Kempf/balsabridge/README.md

Sad but true.
===========
prediction
