Kempf/balsabridge/Report/report.tex

\documentclass[12pt]{article}
	\usepackage{graphicx,amsmath,textcomp}
	\usepackage[round]{natbib}
	\usepackage[margin=3cm]{geometry}
	\linespread{1.3}
	\bibliographystyle{plainnat}
	\title{
		Group \#07 \\
		Bridge-00 \\
		18g, 1700N \\[1cm]
		
	}
	\author{
		Alex Miles \\ u5568175 \\ 16.7\%
		\and Arlene Mendoza \\ u5589650 \\ 16.7\%
		\and Itsuki Nishida \\ u5578430 \\ 16.7\%
		\and Paul Apelt \\ u5568225 \\ 16.7\%
		\and Stephen Lonergan \\ u5349877 \\ 16.7\%
		\and Thomas Hale \\ u5568225 \\ 16.7\%
	}
\begin{document}
	\maketitle
	\thispagestyle{empty}
	\setcounter{page}{0}
	\section{Design}
		% design assumptions and methods
		\subsection{Assumptions}
		During the design process, the following assumptions have been made \citep[p.~264]{tbook}:
		\begin{enumerate}
			\item All loadings are applied at the joint,
			\item Weight of the members neglected,
			\item Joints are smooth (friction-less) pins,
			\item Each member has no more than two joints.
		\end{enumerate}

		\subsection{Considerations}
The task was set with a design criteria to span a gap of 180~mm and a width of 70~mm. The entire bridge also the bridge should weigh less than 18~g. The goal was to be able to hold the largest weight possible.

A very important design consideration was how many 2D truss panels should be used. The idea was by having more panels the design would be distributing the weight and if the layers span the 70~mm the design would be more efficient with its wood use. This is because we no longer need pieces holding the trusses together that don't add significantly to the strength of the design. This would be a better use of the wood as all of our wood would be focused on holding a load applied from above. 

Starting with a 70~mm wide layer of Warren trusses spanning 180~mm ran into a few problems. The largest limitation on the design was the materials allowed this meant the more triangles in the Warren truss the lower the truss had to be. This would create more smaller triangles which would increase the material. Several designs were looked at but it was found that spanning the gap required using a Warren truss didn't work due to the limit of material. However by removing all the triangles we had the outside of the truss which was in the shape of a trapezium. 

Another factor was also making sure that the force was applied onto the joints and not onto one member therefore the top of the bridge where the loading is applied should be less than 70~mm. The top of the bridge runs into the supports on both sides of the bridge and this transfers the load directly into the ground on either side of the trapezium. This takes advantage of the surface reactions. Because of this the more vertical the side pieces the better as they will distribute more of the force onto the support reactions rather than the other sections of the bridge. This is under the assumption that the sides don’t break but if more force is downwards then some of the bracing stopping the bottom from slipping outwards wouldn't be needed and could instead could be moved to the sides.  

As these side pieces are taking the largest force it was decided to use the 5~mm pieces here. To stop the pieces from sliding out some of the 3~mm pieces on the bottom were used to hold the two ends of the design together and prevent slipping.The original design had half the pieces on the bottom as there were on the top. This bridge was tested rather imperfectly as the weight was skewed off centre and so broke earlier than expected. 

By moving two pieces of 5~mm to the sides of the top it was found that we could double the number of pieces along the bottom. Theoretically the top and bottom of the truss take the same force and this is shown later in the calculations. By moving the 5~mm pieces to the top the top was 100~N stronger than the bottom and so the wood was being used efficiently as this gap is relatively small. The side supports while stronger would actually fail before the top does but after the bottom does and therefore the wood is being used very efficiently. The theoretical predictions for this later in the report shows that this is indeed the case.

One thing also considered but decided against was gusset joints, it was decided that gusset joints would not be used for for two reasons. First of all was the material constraints, however this wasn't the biggest concern. The biggest concern was that gusset jointing due to how the joints are situated would be very similar to lamination, which was not allowed.

\subsection{Construction}
All the pieces were measured to the lengths in Table~\ref{list}, and they were then cut. Although the measuring was accurate, you lose some material whenever you cut. So to minimize loss of length, the pieces need to be cut in priority of one another. The 3~mm longest bottom pieces were cut first as these were extremely important to be at a full length. Total amount of material used is recorded in Table~\ref{materials}.
		\begin{table}[h!]
			\caption{List of member lengths.}
			\begin{center}
			\begin{tabular}{ | r | l | r | r | }
				\hline
				qty. & type & size & length \\ \hline
				7 & bottom & 3$\times$3~mm & 187~mm \\ \hline
				7 & top & 3$\times$3~mm & 70~mm \\ \hline
				2 & top & 5$\times$5~mm & 70~mm \\ \hline
				16 & sides & 5$\times$5~mm & 103.75~mm \\ \hline
			\end{tabular}
			\end{center}
			\label{list}
		\end{table}
		\begin{table}[h!]
			\caption{Materials used.}
			\begin{center}
			\begin{tabular}{ | r | r | r | }
				\hline
				size & given & used \\ \hline
				3$\times$3~mm & 1800~mm & 1799~mm \\ \hline
				5$\times$5~mm & 1800~mm & 1800~mm \\ \hline
			\end{tabular}
			\end{center}
			\label{materials}
		\end{table}

The leftover pieces were used to create the top of the bridge, these have the least priority as their length can be compromised if need be. Two 5 ~mm pieces are used on the top of the bridge. The 5~mm sides should be cut to the maximum length possible using the leftover material. Making them taller will distribute the more force into the support reactions. A small reduction in length would however not drastically reduce the maximum load. 

A template/scale diagram of the trapezium shape was then made to gain accuracy in the angles that needed to be attained (56\textdegree). Place the sides of the trapezium (5~mm) down with the top and bottom 3~mm pieces on top. Ignore the lone 5~mm top piece as this will be glued on last for ease of construction. Once enough glue (an amount when the two wood pieces are placed against each other that glue comes out from either side) was applied to the wood, the pieces were aligned to be at angles to each other and that the top and bottom pieces were in parallel. Weights were then placed to apply pressure to the joint. This would ensure the glue attains its maximum strength. The joints were then left to dry for each layer around 10 mins for another layer to be placed on top. The entire process was repeated until 8 layers were made.  The two 5~mm top pieces were then added to either side.

		Final bridge design can be seen in Figures \ref{dim} and \ref{proj}.
		\begin{figure}[h!]
			\centering
			
			\caption{Dimensioned drawing.}
			\label{dim}
		\end{figure}
		\begin{figure}[h!]
			\centering
			
			\caption{3D-Projection.}
			\label{proj}
		\end{figure}
		% dimensioned drawing
		\subsection{Methods}
		% construction process 
		% materials Used
		% difficulties faced - measuring accurately, It ended up being 185~mm than 187~mm and the trapezium was also slightly lopsided by a 1~mm, angles are fucked!
		% weight issues - excess glue fail 
		% picture of the materials used
	\section{Analysis}
		Due to the unconventional design, to ease the calculations during the analysis, it was assumed that the load is equally distributed between eight trapezium-shaped trusses. Thus, a single trapezium truss was analyzed, and then extended to approximate the entire bridge. Internal forces, nodes and members are labelled as per Figure~\ref{trap}. As the truss is symmetrical, only two nodes needed to be analyzed.
		\begin{figure}[h!]
			\centering
			
			\caption{Trapezium truss.}
			\label{trap}
		\end{figure}
		For a load of 100N divided equally between nodes A and B, force equilibrium for nodes A and C are described in equation blocks \ref{eqn1} and \ref{eqn2} respectively.
		% insret calculations here
		\begin{subequations}
			\begin{align}
				F_s \sin 56&=50\mathrm{N}, \\
				F_s \cos 56&=F_t.
			\end{align} \label{eqn1}
		\end{subequations}
		\begin{subequations}
			\begin{align}
				F_s \sin 56&=F_r, \\ 
				F_s \cos 56&=F_b.
			\end{align} \label{eqn2}
		\end{subequations}

		The results of solving the above equations are presented in Table~\ref{loads}. Note that the internal force experienced by members is twice the given value, because it occurs at both ends.
		% table of member loads
		\begin{table}[h!]
			\caption{Member loads.}
			\begin{center}
			\begin{tabular}{ | r | l | }
				\hline
				70 3$\times$3 ~mm (top) & 33.7 N (c) \\ \hline
				103.75 5$\times$5 ~mm (side) & 60.3 N (c) \\ \hline
				187 3$\times$3 ~mm (bottom) & 33.7 N (t) \\ \hline
			\end{tabular}
			\end{center}
			\label{loads}
		\end{table}

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

		Buckling loads were calculated for members under compression (using equation~\ref{eqb}), and it found that the buckling loads of members under compression (see Table~\ref{buck}) did not exceed maximum load, therefore buckling was not critical.
		\begin{equation}
			P_b=\frac{\pi^2 E I}{(kL)^2}
			\label{eqb}
		\end{equation}
		\begin{table}[h!]
			\caption{Maximum buckling loads.}
			\begin{center}
			\begin{tabular}{ | r | l | l | }
				\hline
				& average & $-1\sigma$ \\ \hline
				3$\times$3 70 ~mm (c) & 163.1 N & 163.0 N \\ \hline
				5$\times$5 103.75 ~mm (c) & 573.1 N & 572.7 N \\ \hline
			\end{tabular}
			\end{center}
			\label{buck}
		\end{table}
		% reasons

		To predict the maximum load, the weakest section of the bridge had to be found. That was done by first su~mming up the maximum loads of all top, bottom and side members, (equation block~\ref{eqsa}), using values from Table~\ref{maxloads}, average column.
		\begin{subequations}
			\begin{align}
				P_{top}&=7\times108+2\times300
				&=1356\mathrm{N}\\
				P_{side}&=8\times300
				&=2400\mathrm{N}\\
				P_{bottom}&=7\times180
				&=1260\mathrm{N}
			\end{align}
			\label{eqsa}
		\end{subequations}

		Then the safety rations (defined in equation~\ref{eqr}) were calculated for each section (equation block~\ref{eqrl}), using values from Table~\ref{loads}.
		\begin{equation}
			R=\frac{P_{max}}{P}
			\label{eqr}
		\end{equation}
		\begin{subequations}
			\begin{align}
				R_{top}&=40.2\\
				R_{side}&=39.8\\
				R_{bottom}&=37.4
			\end{align}
			\label{eqrl}
		\end{subequations}

		The lowest safety ratio member will break first, thus bottom was determined to be the breaking point (snapping-type failure). The actual maximum load was determined in equation block~\ref{eqt}, where $P$ is the load used to calculate $R$. The same steps were carried out in equation block~\ref{eqs}, but the strength was assumed to be $1\sigma$ below average.
		\begin{subequations}
			\begin{align}
				F&=\frac{R P}{2} \\
				&=1869.4
			\end{align}
			\label{eqt}
		\end{subequations}
		\begin{subequations}
			\begin{align}
				F&=\frac{R_{\sigma} P_{\sigma}}{2} \\
				&=1551.6
			\end{align}
			\label{eqs}
		\end{subequations}

		The average of the two $1710.5\mathrm{N}$, was chosen as predicted maximum load.
	\section{Results}
The predicted strength of the bridge was 1700~N while the maximum force that it sustained during the test was 875~N. This the most significant contributor to this imprecise prediction was that the bridge was too short to comfortably span the 18~cm gap. Furthermore, gluing techniques were not researched and as a result the joints were not as strong as they otherwise may have been.

Originally the bridge was designed to be 18.7~cm long – just enough to span the 18~cm gap. However, on the day of testing the bridge was found to be over the weight limit and in an attempt to fix this the bridge was sanded. After the sanding process the bridge was found to be 18.4~cm, which left 2~mm either side of the gap. Consequently, during the test the bridge slipped under the applied force and rotated so that roughly half the length of one side of the bridge was no longer in contact with the wood block. As a result the proportion of the distributed load applied to this section of the bridge produced a shear at this point in the row of joints. This shear force was maximum at point A (shown in Figure~\ref{loadtop}). This caused the joint at this point to break which can be seen in Figure~\ref{failtop} as the middle joint --- the fifth joint from the top.
		\begin{figure}[h!]
			\centering
			
			\caption{Half of the top joint row under load.}
			\label{loadtop}
		\end{figure}

If the vertical force system acting on the top member where the load is applied is taken then this process can be better examined. The pressure exerted by the loading plate is assumed to be resolved into distributed loadings along the joints at either end of the 7$\times$7~cm area at the top of the bridge. For this analysis the line of joins is taken as a rigid body with a fixed support reaction at A where it joins the joints that are part of the bridge that has not come off the block. Halfway along the length of this rigid body the resultant force is positioned as per figure (shown in Figure~\ref{loadtop}).  For equilibrium the hypothetical support reactions at A must be equal and opposite to the resultant force and moment. If the structure had not slipped, the vertical forces in the side pieces of the structure would cancel out this distributed load but due to the slipping they do not. As the side of the bridge was pushed downwards, the side members in the bridge would have applied some force to the upper row of joints as the structure tried to maintain its integrity creating another distributed load. This loading however would be small in comparison to the applied load of the block and is thus left out in the following analysis.

Now the internal forces in this rigid body can be analysed using the distributed load and the support reactions.  Figure~\ref{loadtop} shows the distributed load $w \mathrm{(N/m)}$ on the unsupported segment and hypothetical support reaction $A_y$ under an arbitrary load. The intensity of the distributed load is given by the total loading applied by the loading plate divided by $0.14\mathrm{m}$, the combined lengths of the two lines of joints. The equation for the internal shear force along the line of joints is: $V=A_y–wx$ where $x$ is the distance from point $A$ and $V$ is the internal shear force. This equation shows that the internal shear force is maximum at point $A$ ($x=0$) which is where the break occurred. The equation for the internal moment is $M = A_yx –0.5(wx^2)$, where $M$ is the internal moment. $M$ is maximum at $x = 0.035$ or the furthest point along the body from $A$. In reality the moment may be reduced slightly as the structure may bend to compensate for the applied load.

After the joint at point $A$ snapped, the unsupported side of the bridge was displaced downwards, creating a moment about the other row of joints. Initially this caused the fourth joint from the top on the right (as per Figure~\ref{failtop}) to split. Then the joints below it also began to split. As the applied force increased so did the moment and consequently the splitting of the joints.
		\begin{figure}[h!]
			\centering
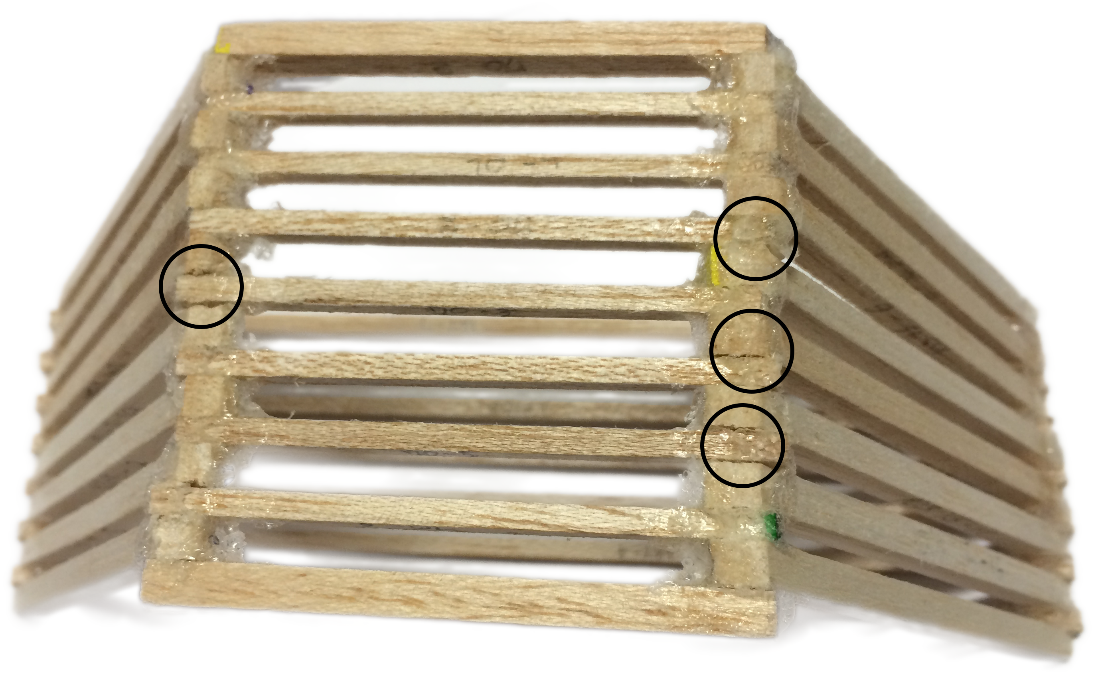
[picture p11: Report/failtop.png]
			
			\caption{Failure points on the top of the bridge.}
			\label{failtop}
		\end{figure}

After these joints snapped half of the bridge was incapable of bearing load and as a result the load bearing capacity of the bridge was halved. This is reflected by the quotient of the measured maximum load and the predicted maximum load, which is approximately one half. So had the bridge been longer and thus protected from slipping, it is likely that it could have supported the maximum predicted load.

When the forces bridge slipped, the joints showed little resistance and failed a within a second after. The reason for this was that far too much glue was used on the joints. According to \cite{glue}, the strength of a joint glued with balsa cement is inversely proportional to the distance between the two surfaces until the distance reaches the width of the molecules of the glue. While several drops of glue were applied to each joint in this bridge \citep{glue} states that even one drop of glue is excessive. In applying such an excessive amount of glue the joints were significantly weakened as the distance between the surfaces of the balsa pieces was increased. However, a glued joint can only be as strong as the material being held together and balsa wood is weaker when a force is applied perpendicular to its grain orientation. The application of significant shear force between joints would cause the wood itself to break and split off. As demonstrated in the analysis above, the maximum shear force in the row of joints is equal in magnitude to the resultant force of the applied load, ignoring the contribution of the distributed load from the side members. Even if it were taken into consideration, the shear force is too high for a joint to tolerate.

If the correct gluing method was applied to the joints of the bridge its maximum loading may have been increased slightly but the primary cause of failure was the length of the bridge and the resultant slipping.
	\bibliography{bib}
\end{document}
