Kempf/balsabridge/Drawings/dimensioned.PNG

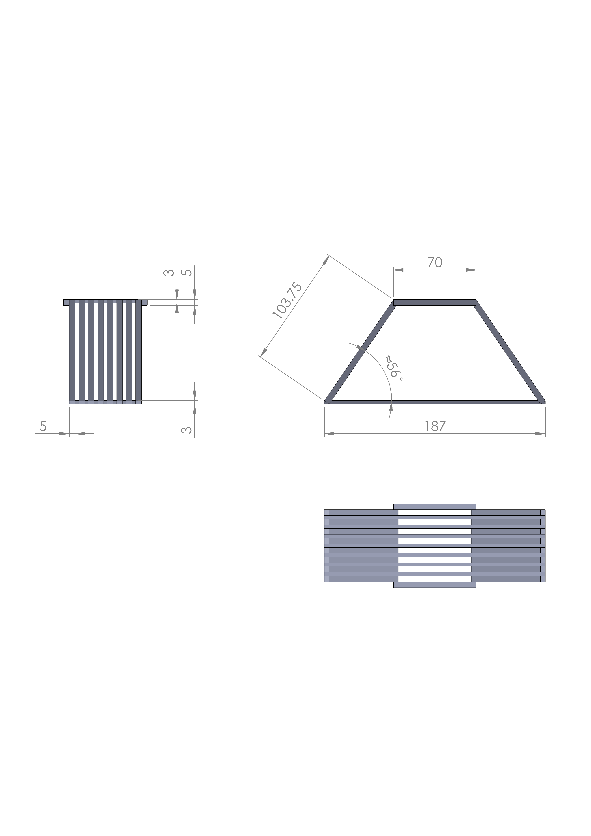
Drawings/dimensioned.PNG
