Kempf/balsabridge/Drawings/projected.PNG

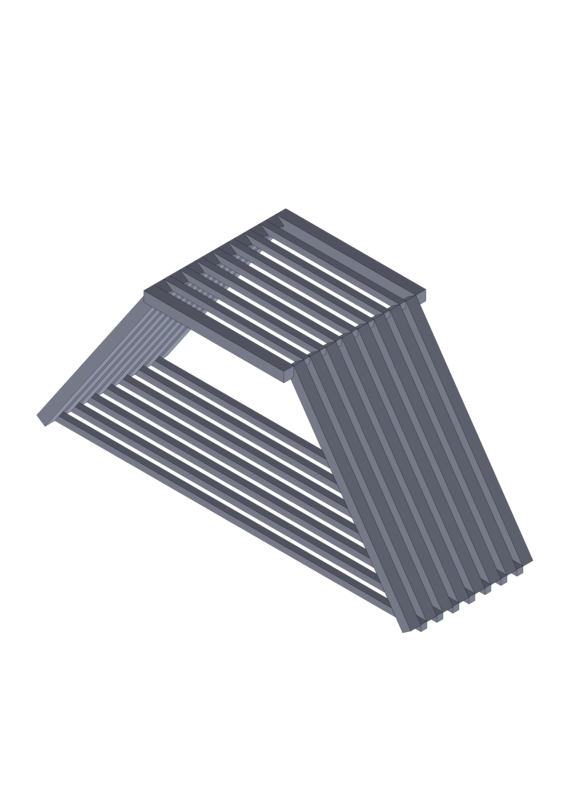
Drawings/projected.PNG
