Kempf/balsabridge/Report/failside.png

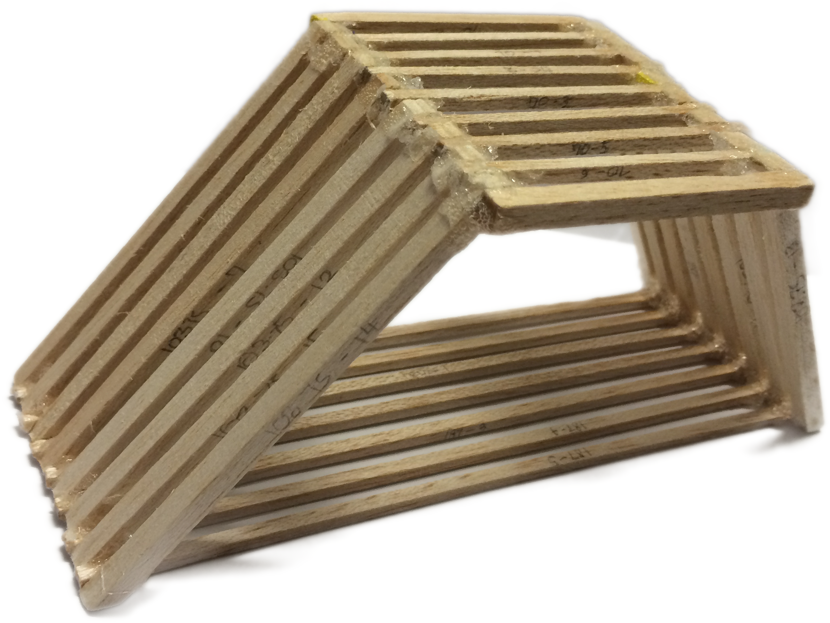
Report/failside.png
