Kempf/balsabridge/Report/failsidelow.png

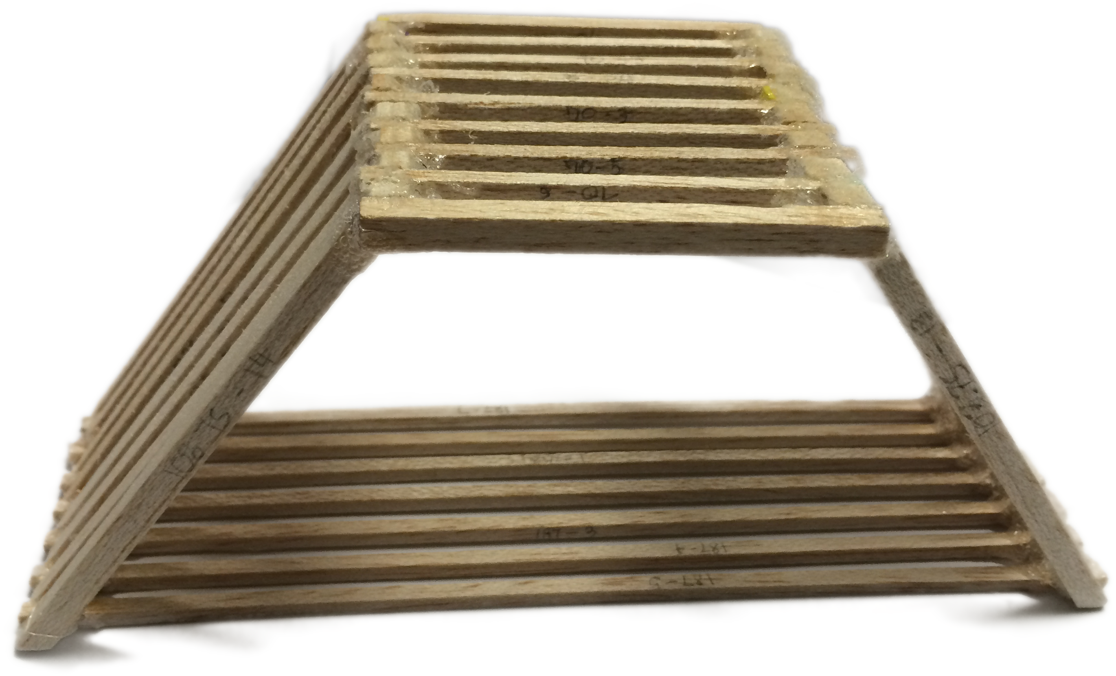
Report/failsidelow.png
