Kempf/balsabridge/Report/LabelledDia.png

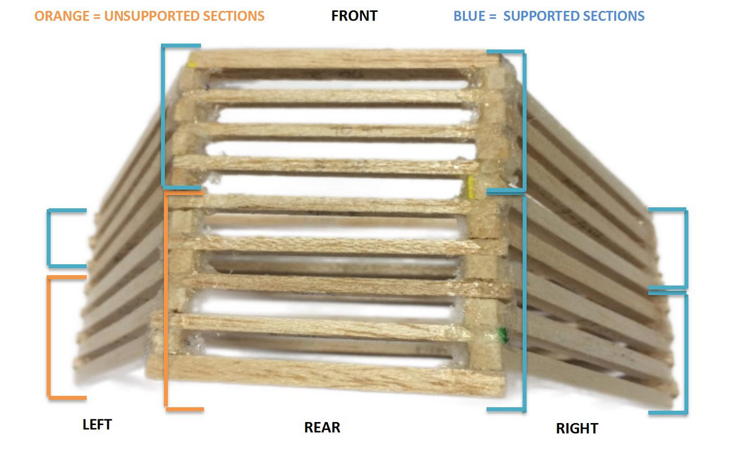
Report/LabelledDia.png
