Kempf/balsabridge/Drawings/section.SLDASM

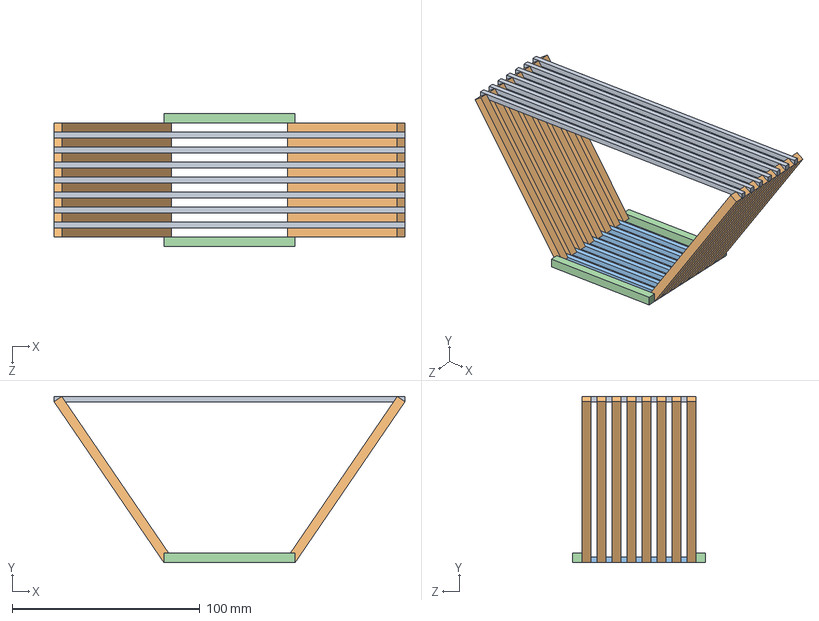
[picture p18: CAD file, 2014-10-06]
Drawings/section.SLDASM
187.0 x 88.5 x 71.0 mm
bottom x 7
side x 16
topmid x 7
topend x 2
