Kempf/balsabridge/Drawings/topmid.SLDPRT

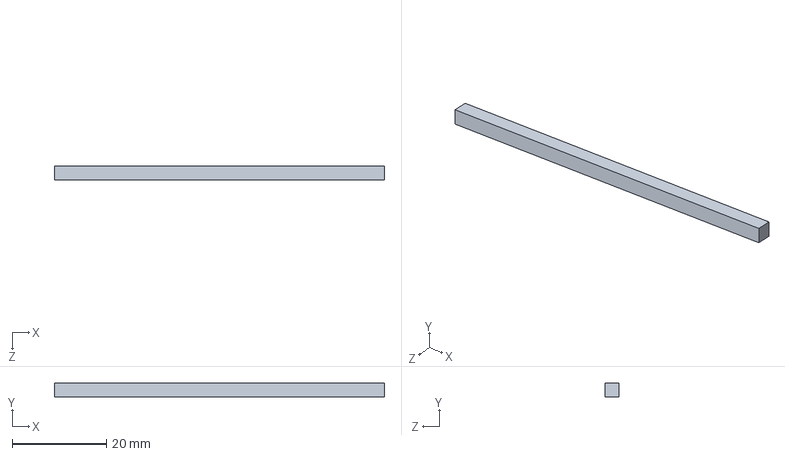
[picture p19: CAD file, 2014-10-06]
Drawings/topmid.SLDPRT
70.0 x 3.00 x 3.00 mm
