Kempf/balsabridge/Drawings/bottom.SLDPRT

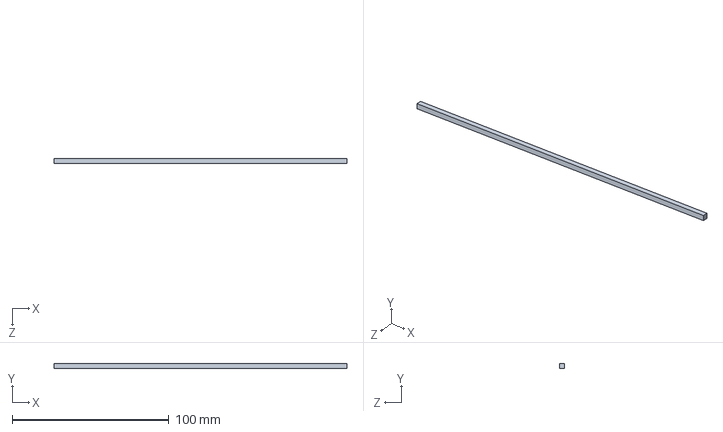
[picture p20: CAD file, 2014-10-06]
Drawings/bottom.SLDPRT
187.0 x 3.00 x 3.00 mm
