Kempf/balsabridge/Drawings/topend.SLDPRT

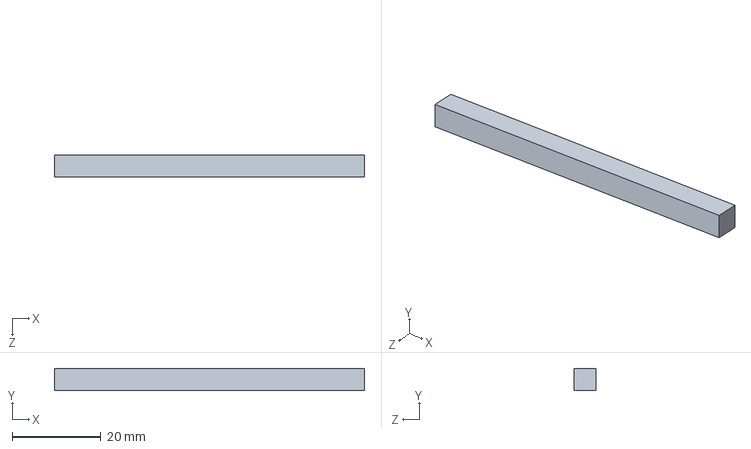
[picture p21: CAD file, 2014-10-06]
Drawings/topend.SLDPRT
70.0 x 5.00 x 5.00 mm
