Kempf/balsabridge/Drawings/side.SLDPRT

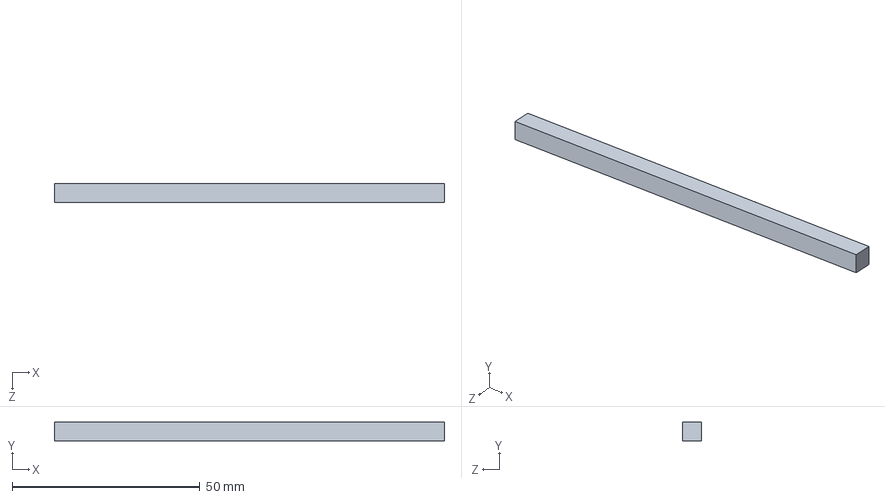
[picture p22: CAD file, 2014-10-06]
Drawings/side.SLDPRT
103.8 x 5.00 x 5.00 mm
