Kempf/balsabridge/(list of files, cad)

Other CAD files:
Drawings/dimensioned.SLDDRW
Drawings/projected.SLDDRW
