Kempf/balsabridge/(commit log)

2014-10-06 Added 3D models
    [bottom.SLDPRT, dimensioned.SLDDRW, projected.SLDDRW, section.SLDASM, side.SLDPRT, topend.SLDPRT, topmid.SLDPRT]
2014-10-09 Update report.tex
    "Add dimensions of the 5mm and the 3mm layering?"
    If you look carefully, they are already there. All the unique members are dimensioned. Anything more than that is redundant.
2014-10-12 Updated calculations
    [dimensioned.SLDDRW]
2014-10-14 Added buckling
2014-10-16 Added design method. Currently at 10 pages
